dgngdn/APPJ_Control/Software/thermal-camera/lepton.md

## Software Stack

Thermal images can be acquired from the camera using pylepton

## Resources

+ [Google Docs: FLIR Long-Wave IR Camera][gdocs]
+ [Sparkfun: Lepton Hookup Guide][sparkfun-hookup]
+ [Sparkfun: Raspberry Pi GPIO][sparkfun-gpio]

[gdocs]: https://docs.google.com/document/d/1TSdYhewRoLGEG73hs67lw2xULN_MWT7IZJxQMNzIlGo/edit
[sparkfun-hookup]: https://learn.sparkfun.com/tutorials/flir-lepton-hookup-guide
[sparkfun-gpio]: https://learn.sparkfun.com/tutorials/raspberry-gpio
