dgngdn/APPJ_Control/Hardware/Misc Documents (Legacy)/serial.md

## Serial Port Settings

Use `stty -F /dev/devicename` to get and set serial port settings.

### Documentation

+ https://www.esrl.noaa.gov/gmd/dv/hats/cats/stations/qnxman/stty.html
+ http://www.real-world-systems.com/docs/stty.1.html
+ http://man.openbsd.org/stty.1
