dgngdn/APPJ_Control/Hardware/Misc Documents (Legacy)/dac/dacs.md

## Digital to Analog Converters

### MCP4922

8/10/12-Bit Dual Voltage Output Digital-to-Analog Converter with SPI Interface

[datasheet]

[datasheet]:http://ww1.microchip.com/downloads/en/DeviceDoc/22250A.pdf

## Digital Potentiometers

### MCP4261 Digital Potentiometer

* [http://www.mouser.com/ds/2/268/22059b-46028.pdf MCP4261 Datasheet]

how does the MCP41010 compare?
+ http://www.microchip.com/wwwproducts/en/en010494
+ http://www.instructables.com/id/Digital-Potentiometer-MCP41100-and-Arduino/
+ http://henrysbench.capnfatz.com/henrys-bench/arduino-output-devices/mcp41010-digital-potentiometer-arduino-user-manual/
+ http://ww1.microchip.com/downloads/en/DeviceDoc/22017c.pdf

    Symbol    		Interface    Resolution    Max DNL    Max INL    Operating temperature    Case    Mounting
    MCP41010-E/P    	SPI    8    ±1   	 ±1    -40...125    DIP8    THT
    MCP4261-103-E/P    SPI    8    ±0.5    ±1    -40...125    DIP14    THT
