dgngdn/APPJ_Control/Hardware/Misc Documents (Legacy)/function-generator/xr2206.md

## Procurement

+ [XR2206 datasheet on Sparkfun][datasheet]
+ [XR2206 at Jameco][jameco]

## Hardware For Implementation

+ LM358AN	op amp		X
+ XR2206CP	function generator
+ MCP4261	digital potentiometer	X
+ optical sensor

**for the op amp**

+ 10000 ohm    10 kohm
+ 15000 ohm    15 kohm

**for the function generator**

+ 10000 ohm	10 kohm	2x
+ 1000 ohm	1 kohm		2x
+ 5600 ohm	5.6 kohm	2x
+ 2a472j		4700pF	1x
+ 1uF		2x
+ 10uF		1x

[datasheet]: https://www.sparkfun.com/datasheets/Kits/XR2206_104_020808.pdf
[jameco]: https://www.jameco.com/webapp/wcs/stores/servlet/ProductDisplay?productId=34972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

## PWM Output

### Shunting the Output

shunt AC signal to ground:
https://electronics.stackexchange.com/questions/271537/bjt-as-switch-to-let-ac-through

Transistor: Q2878:

Muting is traditionally done with a JFET
http://www.avrfreaks.net/forum/transistor-soft-mute

2N5484

"Jfets are used as you don't have the base-emitter junction. If you don't know how jfets work - time to hit Google and get the basics. Last time i used one was 25years ago, so I'm rusty on the finer points. From what i recall, the device is on with no gate bias. Apply bias to the gate to turn it off. Voltage vs current in relation to a bjt."

----

"A simple J-FET switch is easy to accomplish. The use of a P-channel J-FET is required. The more common N-channel will not give the same results, especially fading. A common device is the 2N5462 or the J176 or J177 available from Jameco (part number 140142CF $.59ea or 211414CF $.29ea at 2005 prices)."

http://neatcircuits.com/audiosw/index.html

2SC2878 - designed specifically for this application

----

http://www.electroschematics.com/9660/muting-transistor-attenuator-circuits-2sc2878/

----

https://electronics.stackexchange.com/questions/66332/mosfets-or-bjts-for-using-as-switch-for-audio-signals

"For bipolar AC audio signals, your best choice would be a "transmission gate" chip such as CD4016 or CD4066, or an analog multiplexer chip, which is an array of such gates with a common connection.

These devices have the most symmetrical characteristics, minimizing distortion of audio signals.

Internally, they are a pair of back-to-back MOSFETs driven by complementary control signals."
