dgngdn/APPJ_Control/Hardware/Circuit Diagrams/AC_RMS.png

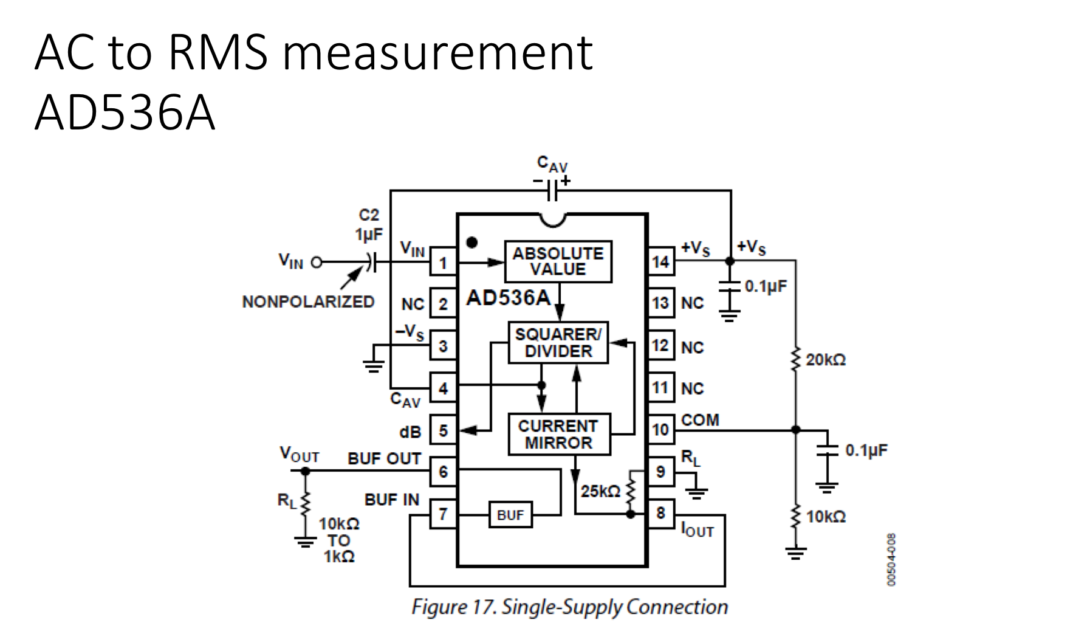
Hardware/Circuit Diagrams/AC_RMS.png
