dgngdn/APPJ_Control/Hardware/Circuit Diagrams/DAC.png

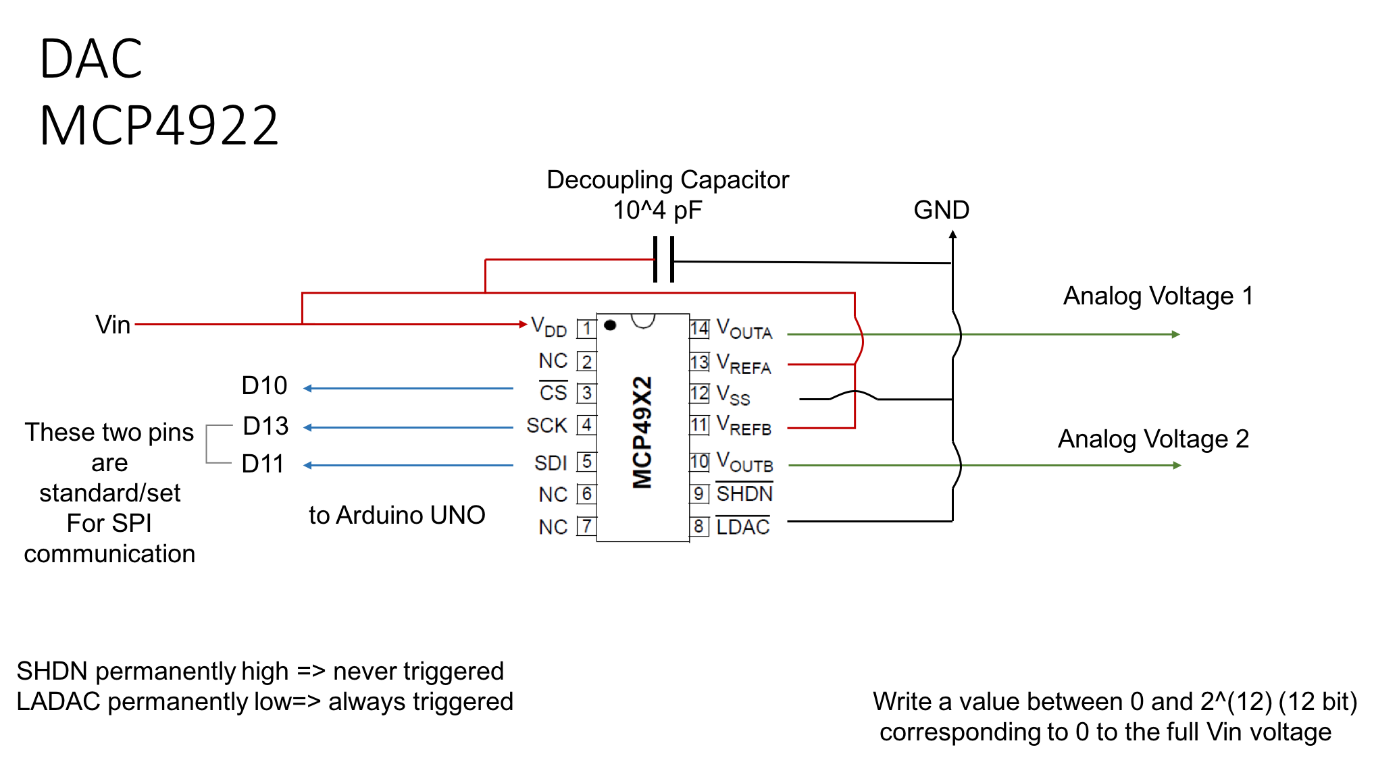
Hardware/Circuit Diagrams/DAC.png
