dgngdn/APPJ_Control/Hardware/Circuit Diagrams/FGEN.png

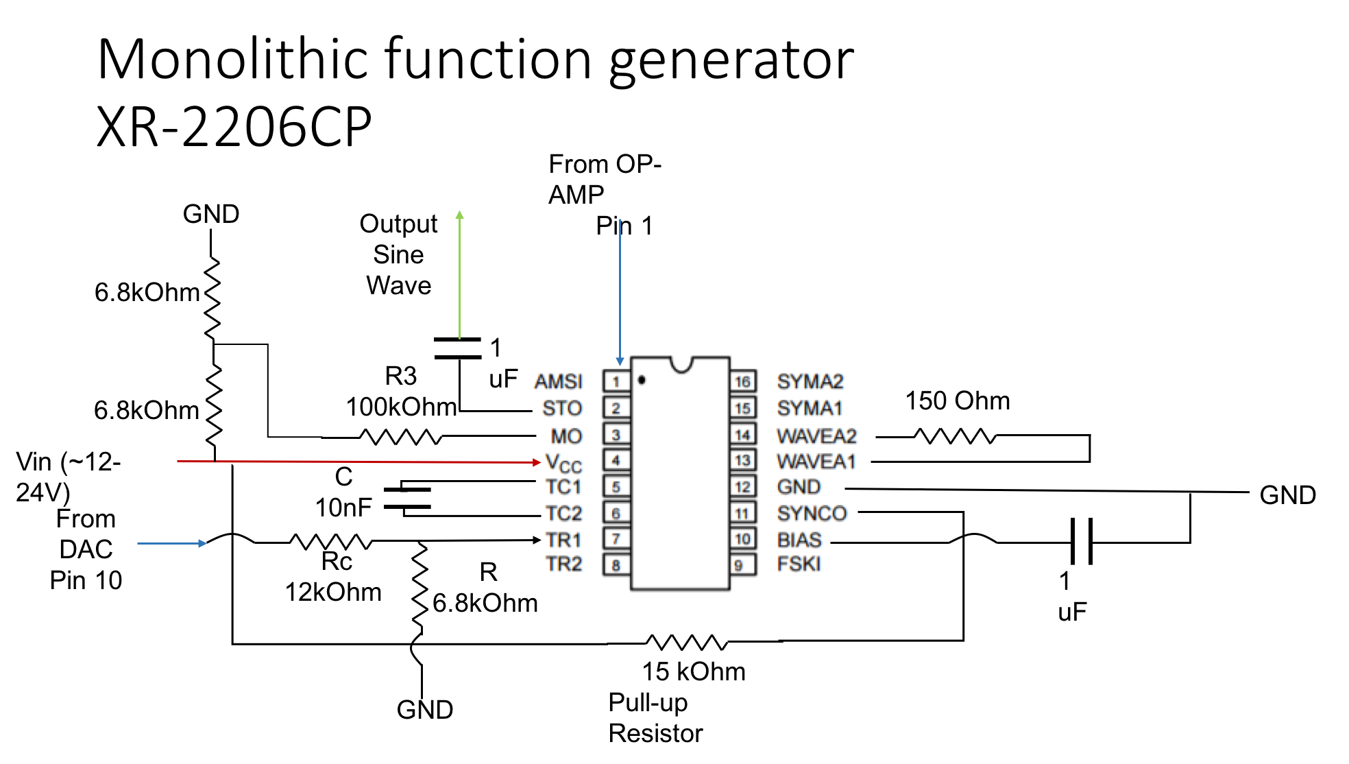
Hardware/Circuit Diagrams/FGEN.png
