dgngdn/APPJ_Control/Hardware/Circuit Diagrams/OPamp.png

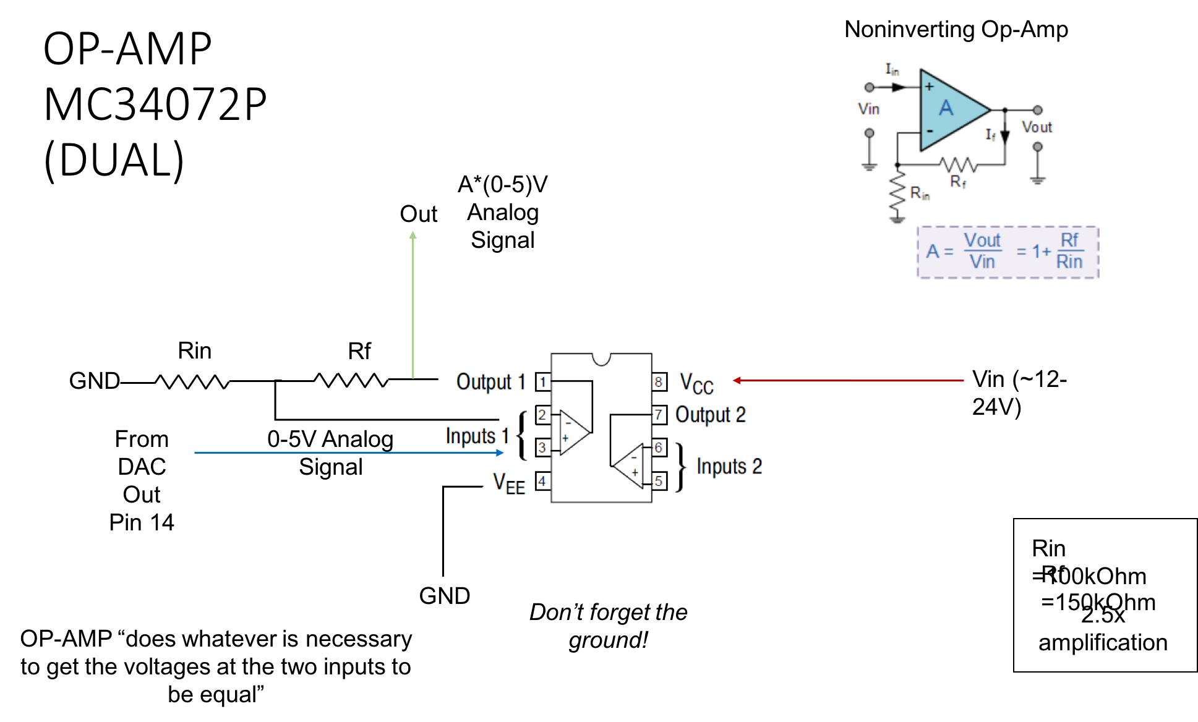
Hardware/Circuit Diagrams/OPamp.png
