dgngdn/APPJ_Control/Hardware/Circuit Diagrams/Switch.png

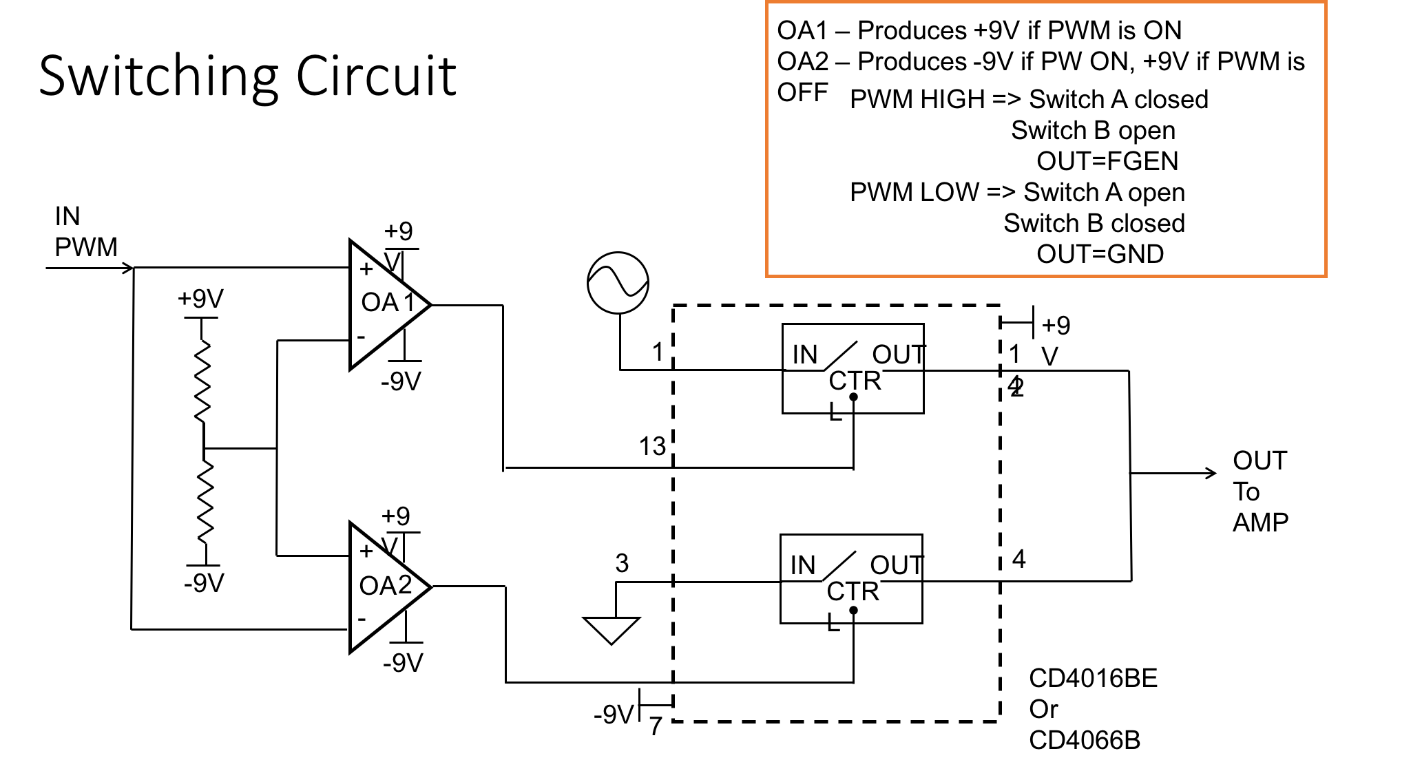
Hardware/Circuit Diagrams/Switch.png
